gaalp03/3dhaz/cad/render/lid.stl

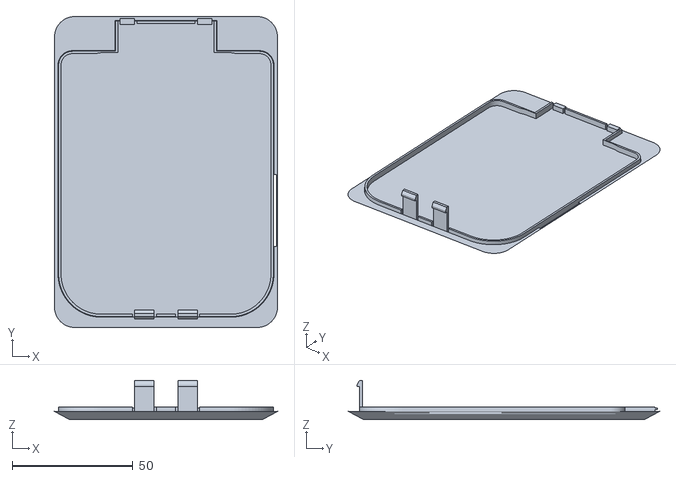
[picture p11: CAD file, 2026-11-07]
cad/render/lid.stl
92.5 x 129.0 x 16.3
