gaalp03/3dhaz/stl/terminal_btn_outer.3mf

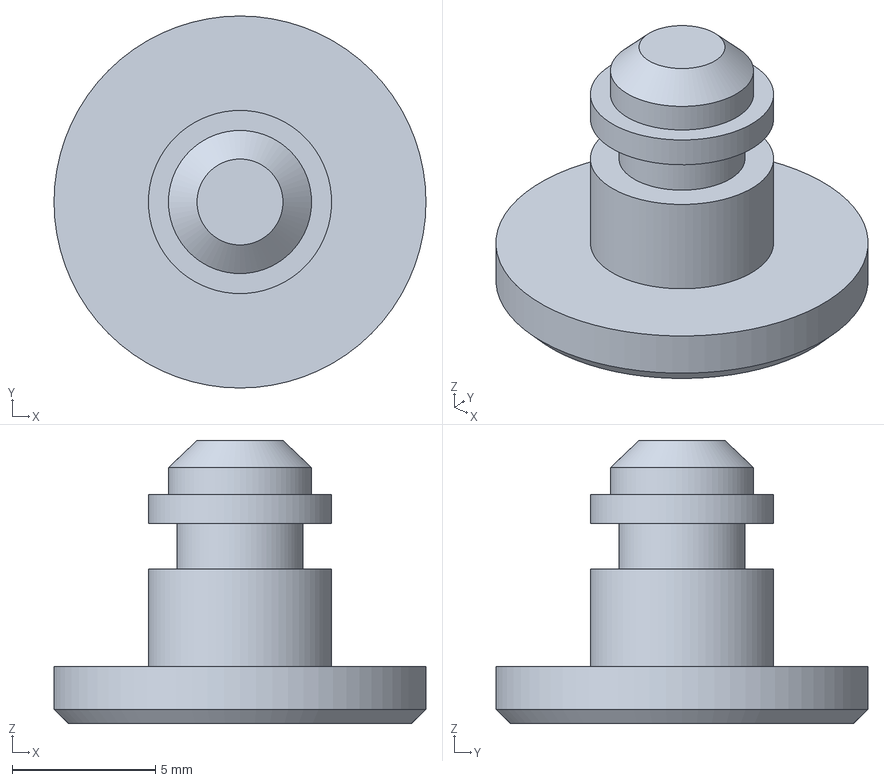
[picture p12: CAD file, 2026-11-07]
stl/terminal_btn_outer.3mf
13.0 x 13.0 x 9.90 mm
