gaalp03/3dhaz/cad/render/top.stl

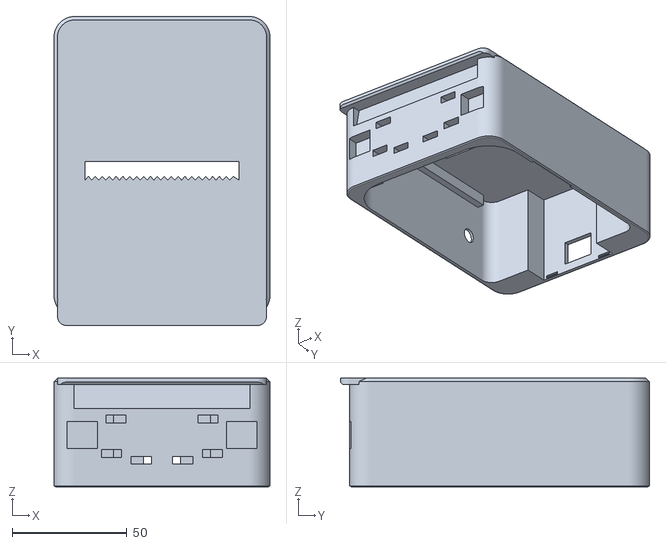
[picture p13: CAD file, 2026-11-07]
cad/render/top.stl
94.0 x 134.5 x 47.3
