gaalp03/3dhaz/cad/render/btn.stl

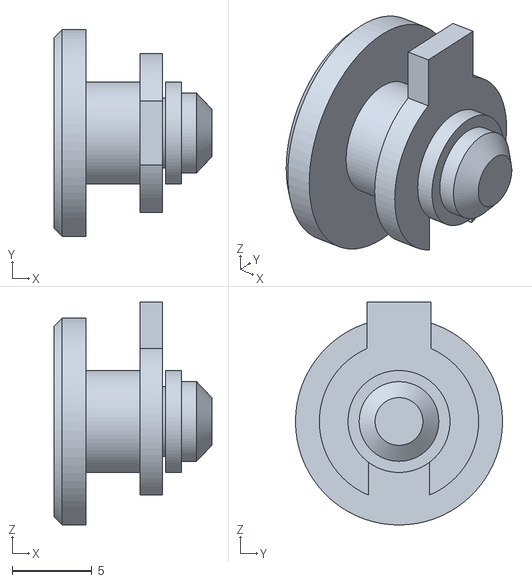
[picture p14: CAD file, 2026-11-07]
cad/render/btn.stl
9.90 x 13.0 x 14.0
