gaalp03/3dhaz/stl/terminal_back.3mf

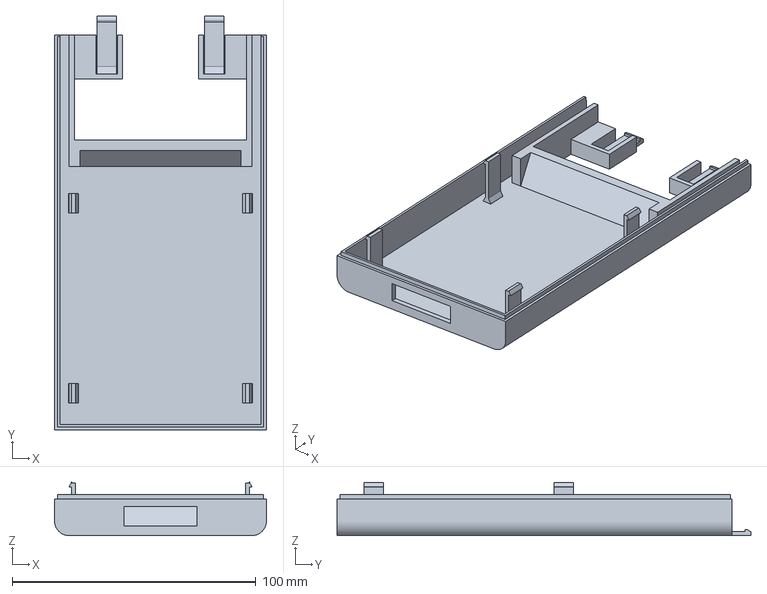
[picture p15: CAD file, 2026-11-07]
stl/terminal_back.3mf
87.0 x 169.7 x 21.8 mm
