gaalp03/3dhaz/cad/render/base.stl

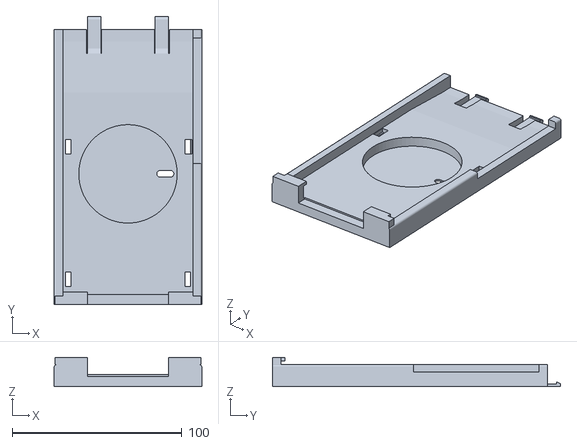
[picture p16: CAD file, 2026-11-07]
cad/render/base.stl
87.0 x 169.7 x 17.2
