gaalp03/3dhaz/stl/terminal_btn_inner.3mf

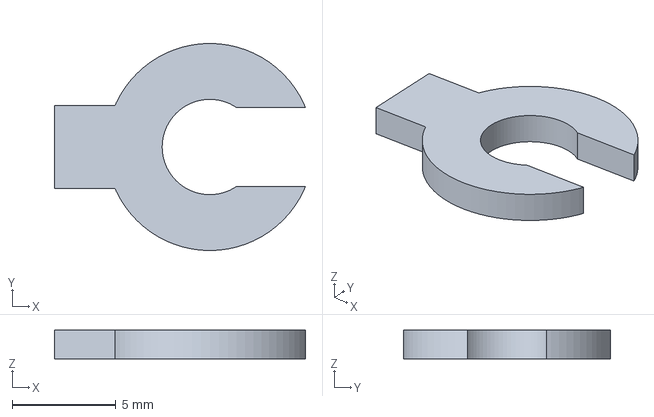
[picture p17: CAD file, 2026-11-07]
stl/terminal_btn_inner.3mf
12.1 x 10.0 x 1.40 mm
