gaalp03/3dhaz/(list of files, cad)

Other CAD files:
stl/terminal_top.3mf
stl/terminal_base.3mf
cad/render/back.stl
stl/terminal_lid.3mf
stl/terminal_back.stl
stl/terminal_base.stl
stl/terminal_btn_inner.stl
stl/terminal_btn_outer.stl
stl/terminal_lid.stl
stl/terminal_top.stl
