gaalp03/3dhaz/(commit log)

2026-11-06 Add printable POS terminal housing for MXW01 printer and S21 FE
    OpenSCAD source, STL/3MF exports for base and top (lid + phone cradle),
    preview renders and README with layout and assembly notes.
    Claude-Session: https://claude.ai/code/session_01JFoGa7VasBMWa1P3j5weRv
    [terminal.scad, terminal_base.3mf, terminal_base.stl, terminal_top.3mf, terminal_top.stl]
2026-11-06 Replace desktop dock with handheld terminal housing (#1)
    Printer housing on top, phone cradle at 55 deg in front, hollow grip leg
    at the back. Qi + magnet ring pocket behind the lower phone area, metal-free
    thin NFC zone behind the top third, internal cable channels to a USB-C
    power inlet in the grip. Exports base/top as STL and 3MF plus renders.
    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
    [terminal.scad, terminal_base.3mf, terminal_base.stl, terminal_top.3mf, terminal_top.stl]
2026-11-06 Rework housing into Teya-style handheld: printer cap on top of phone (#1)
    Printer cap sits on the phone's top edge with the paper slot on its front,
    slim body holds the phone with the full screen free. Qi + magnet pocket
    behind the phone center, metal-free NFC zone with back recess behind the
    top third, small powerbank bay below it, cable lanes to the cap.
    Four printable parts (base, back, top, lid) as STL/3MF plus colored previews.
    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
    [back.stl, base.stl, lid.stl, terminal.scad, terminal_back.3mf, terminal_back.stl, terminal_base.3mf, terminal_base.stl]
2026-11-06 Replace screws with printed snap-fits (#1)
    - Paper-change lid: two L-shaped hinge tongues in a groove at the top,
    two cantilever arms clicking into the cap bottom wall; released by
    pressing the hooks through two small slots under the cap.
    - Body back to body front: four cantilever arms into hidden slots in the
    deck under the phone (screw holes kept only as optional backup).
    - Cap to body: four flat tongues printed in XY (two from the deck, two
    from the back tabs) clicking behind the cap bottom wall; no metal near
    the NFC zone.
    - 30 deg lead-in, square retaining face, 0.3 mm clearance, filleted roots;
    strains kept around 0.5-1.3 %. README recommends PETG.
    - Verified: no overlap wh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
    [back.stl, base.stl, lid.stl, terminal.scad, terminal_back.3mf, terminal_back.stl, terminal_base.3mf, terminal_base.stl]
2026-11-06 Add perimeter alignment rims and snap-fit section drawings (#1)
    - Body back now seats with a 1 x 1.8 mm rim in a groove on the body front;
    paper-change lid has a rim that drops into the cap opening.
    - Section drawings (docs/snap_sections.png) cut from the actual model show
    each hook engaging its ledge/window.
    - Re-verified: no overlap assembled, hooks engage on pull, rims resist
    sideways shift.
    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
    [back.stl, base.stl, lid.stl, sections.scad, terminal.scad, terminal_back.3mf, terminal_back.stl, terminal_base.3mf]
2026-11-06 Remove all screw holes and bosses; snap-fits only (#1)
    - Drop the four optional M3 holes (with countersinks and driver access)
    from the phone tray and the matching bosses from the body back.
    - Qi cable passage is now an oval slot so it is not mistaken for a screw hole.
    - README no longer mentions backup screws; adds a tray view.
    - Re-verified: parts watertight, body halves still snap and seat.
    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
    [back.stl, base.stl, terminal.scad, terminal_back.3mf, terminal_back.stl, terminal_base.3mf, terminal_base.stl, terminal_lid.3mf]
2026-11-06 Close the right-side paper-release window on the cap (#1)
    The owner changes paper by taking the printer out, so the latch window is
    no longer needed. The right cap wall is now a closed, smooth wall; inside
    it gets a 1 mm pocket (open toward the lid) so the protruding paper latch
    still clears when the printer is inserted from the back. The matching
    cut-out in the lid rim is removed. Snap-fits, power window, paper slot and
    USB-C opening are unchanged.
    Verified: right wall solid from outside, latch mock-up clears in place and
    along the insertion path (also shifted +/-4 mm), lid snaps still engage.
    Claude-Session: https://claude.ai/code/s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
    [lid.stl, terminal.scad, terminal_back.3mf, terminal_base.3mf, terminal_lid.3mf, terminal_lid.stl, terminal_top.3mf, terminal_top.stl]
2026-11-07 Phone insertion fix and two-piece extended power button (#1)
    Phone lips: retention was fine but simulation showed the phone could only
    be inserted almost flat (interference from ~2 deg). Added a 2 mm dip in the
    tray under the phone top (ramp 120->150 mm), a 1 mm lead-in chamfer on the
    cap lip and a sloped end on the phone slot. Insertion now clears from 0 to
    ~18 deg; 3.5 mm insertion travel, 2.7 mm top overlap and bottom lips are
    unchanged, and tilting a seated phone is still blocked at both ends.
    Power button: the old left window boolean did not cut through the wall.
    Replaced with a captive two-piece push button: outer part (13 mm head,
    6.4 mm shaft, conical tip) through a 7 mm hole with a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
    [back.stl, base.stl, btn.stl, button_section.scad, lid.stl, terminal.scad, terminal_back.3mf, terminal_back.stl]
